Richard-Willke/Upper-Body_Exoskeleton/README.md

# Exoskeleton Project 

NOTE: A video of the project in action can be found [here](https://youtu.be/HH42bnDa1DE).

Goal of this project is the design of a rigid exoskeleton aimed to support elbow flexion-extension and wrist pronation-supination movements. 
The CAD model is shown below and can be found [here](https://github.com/Richard-Willke/Upper-Body_Exoskeleton/tree/main/Exoskeleton_Project_workspace/cad): 

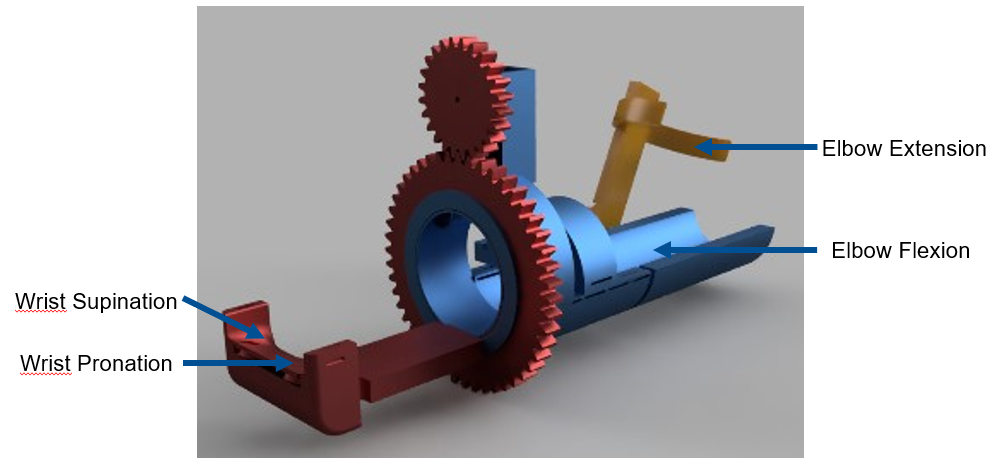
[picture p1: media/Screenshot_348.png]


## Program Architecture

The programme is split on two systems. An ESP32 microcontroller is used for low-level, real-time sensitive controls, while the high level commands and system kinematics & dynamics are being handled on a more powerful PC. The PC and microcontroller communicate with one another via a USB connection. 

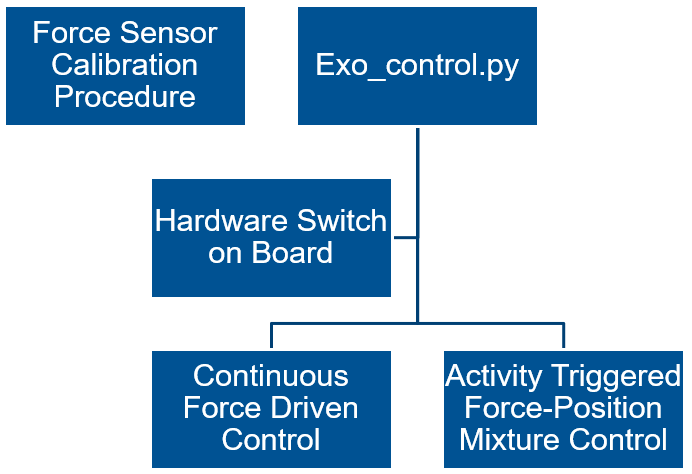
[picture p2: media/Screenshot_349.png]


## System Hardware

The system uses a force controlelr for action commands. Actuation is done using servo-motors and gear transmissions.  

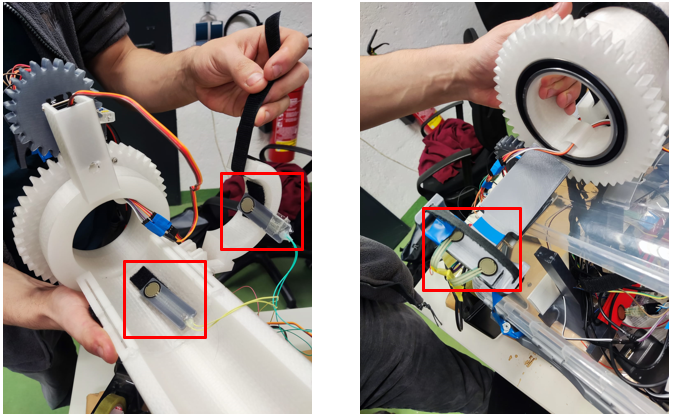
[picture p3: media/Screenshot_350.png]


## System Results 

pn

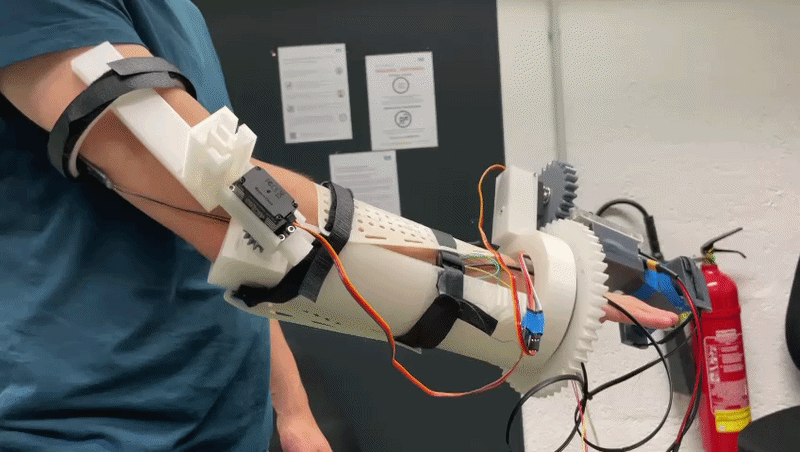
[picture p4: media/flex_extend.gif]
fe
