Richard-Willke/Upper-Body_Exoskeleton/Documentation/Closing_Presentation.pptx

## Practical Course Wearable Robotics Group 2: Wrist Pronation / Supination

- Lingfeng Gu, Richard Willke Nikolas Kaarsberg
- Technische Universität München
- TUM School of Computation, Information and Technology
- Institute for Congitive Systems
- Munich, 9. January 2024

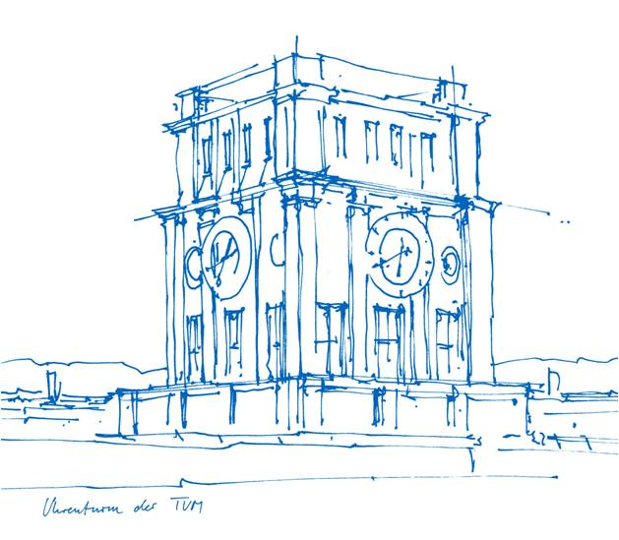
[picture p5: figure]

## Use Case

- Scenarios:
  - Picking up Cup for people with fast muscular fatigue
  - Learning of picking up motion for people with impaired RoM

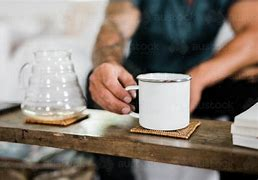
[picture p6: figure]
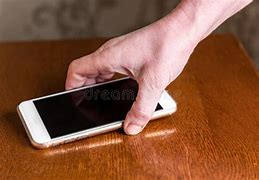
[picture p7: figure]
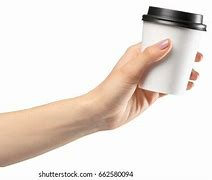
[picture p8: figure]

Lingfeng Gu, Richard Willke, Nikolas Kaarsberg | Wearable Robotics | Wrist Pronation & Supination

Notes: Picking up tasks / Grasping action
Goal: Helping People with muscular distrophy

## Approach

- Main Motion Contributers:
  - Elbow Flexion / Extension
  - Wrist Pronation / Supination
Assistive Modes:
    - Continuous Assistance
    - Activity Triggered
Requirements:
    - Ease of use
    - Reliability
    - Comfort
    - Realtime Capable

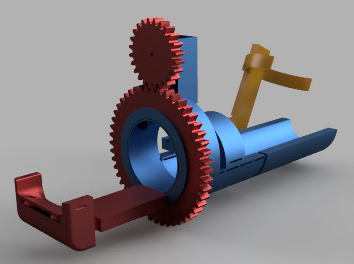
[picture p9: figure]

Notes: 2 DoF exoskeleton for muscular support
Elbow Flexion and Extension & Wrist Pronation / Supination as most important contributers for this task
Continuos assistance for first scenario
Activity triggered assistance for second scenario
Requirements:
Ease of use
Reliability
Comfort
Realtime capable

## Mechanical Design

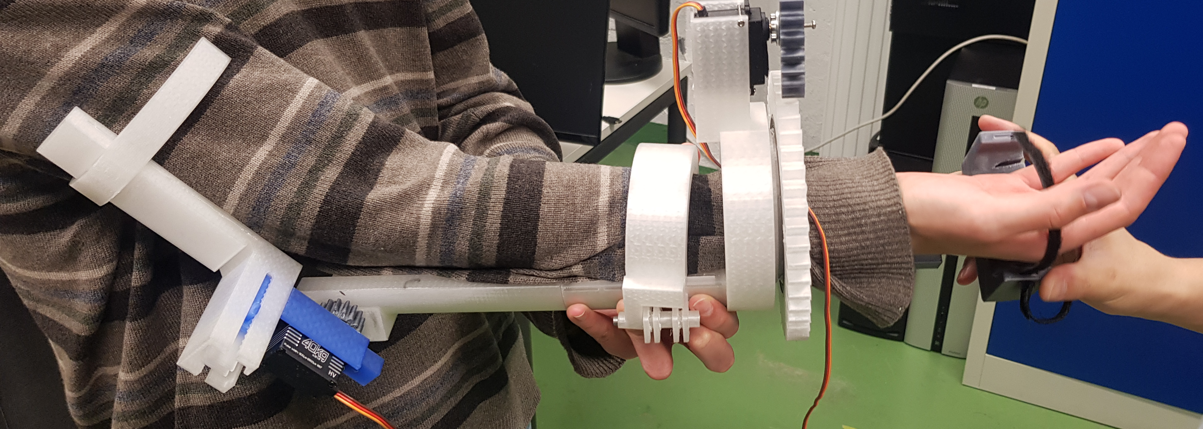
[picture p10: figure]
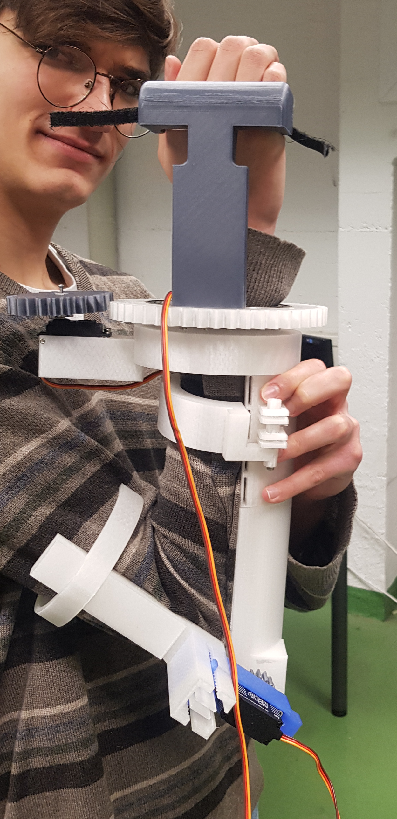
[picture p11: figure]
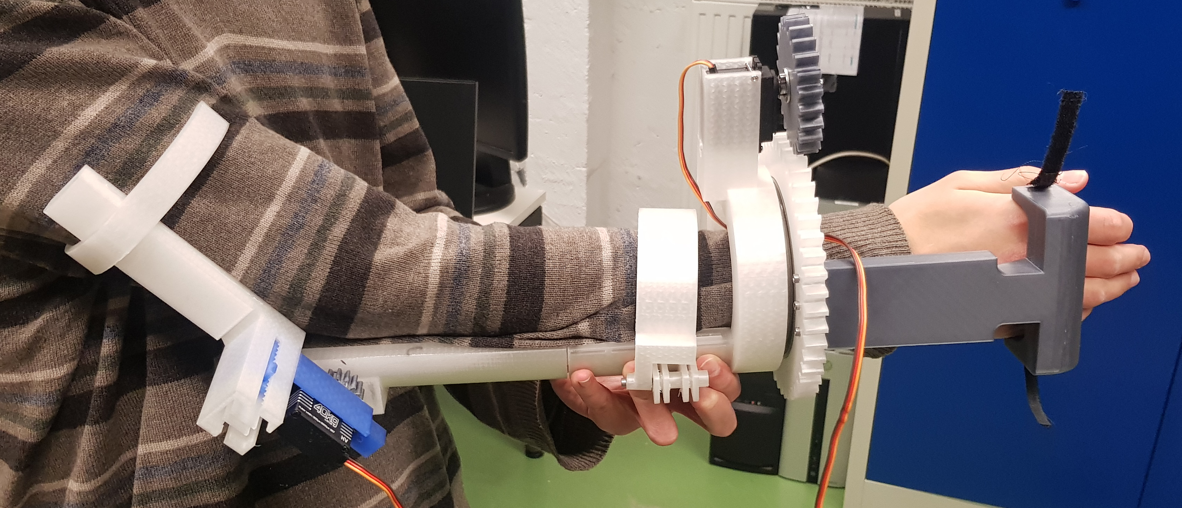
[picture p12: figure]

## Controls and Sensing

ESP32exo.ino

triggeredControl

- __init__
- deg2rad
- assist_loop2

open_serial_port.py

exoControl

- __init__
- deg2rad
- rad2deg
- checkRange
- control_loop

exo_control.py

## Controls and Sensing

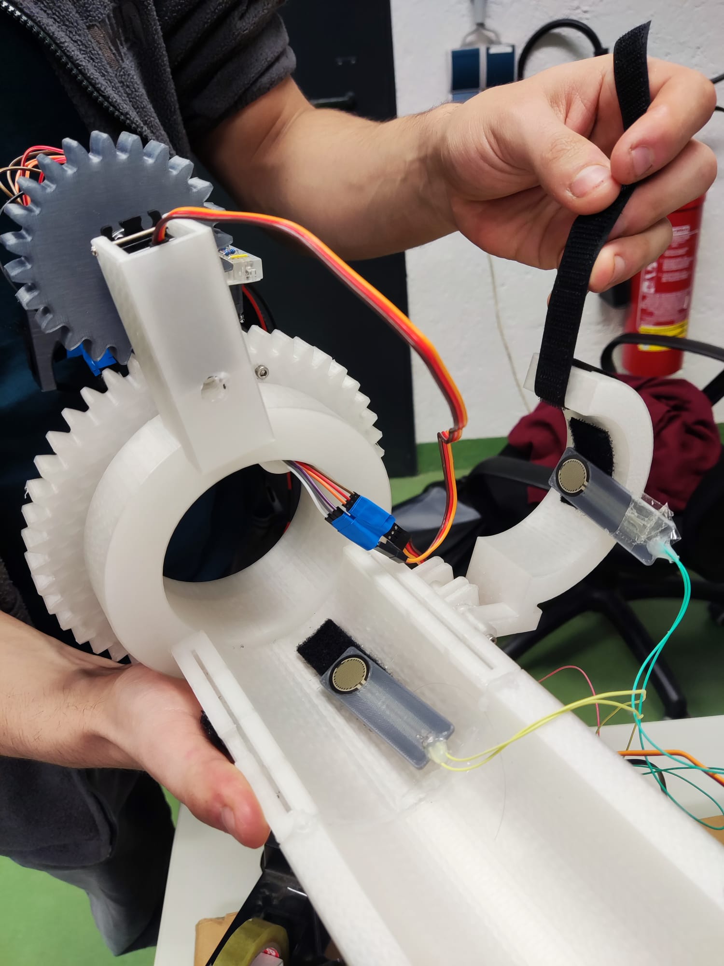
[picture p13: figure]
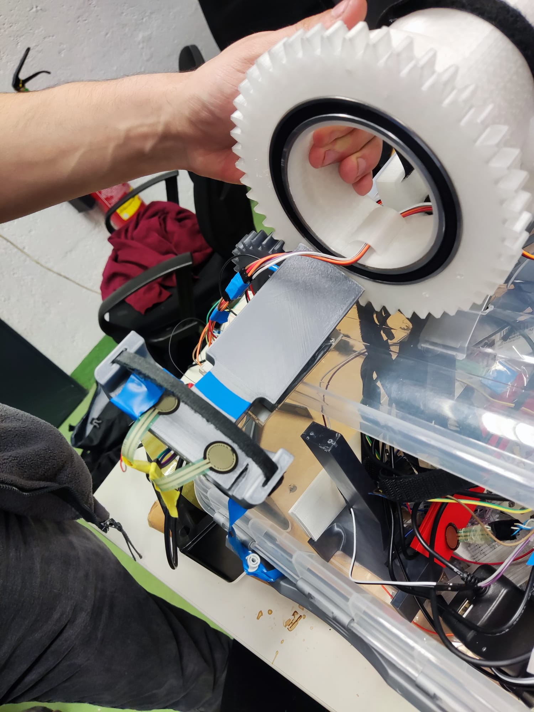
[picture p14: figure]

Notes: Using Force Sensors for both Control Modes
Sensors located along the outer knuckles of the hand and inner / outer side of lower arm
Used to calculate the wrench for both motions

## Results and Future Work

## Thank you for your attention!

Lingfeng Gu, Richard Willke, Nikolas Kaarsberg | Wearable Robotics | Wrist Pronation & Supination
