Richard-Willke/Upper-Body_Exoskeleton/Exoskeleton_Project_workspace/simulation/MATLAB Simulation/README.rtf

This matlab file shows the continuous control of a 2DOF model of exoskeleton with wrist pronation/suponation as well as elbow flexion/extension. This file structure is adapted and based on course of MSBRDM.
To see the simulation result, you can open the DSimulator_R2023a.mdl.
- modify the parameters at blocks q1d and q2d to see the result of trajectory following.

To use different control modes, go to the Tau.m file:
- uncomment the line 69. to enable the force control modes, then you can modify the parameter blocks tau1 & tau2 in Simulink to simulate the forces applied on both torques.
