Richard-Willke/Upper-Body_Exoskeleton/Exoskeleton_Project_workspace/cad/Exoskeleton_model.stl

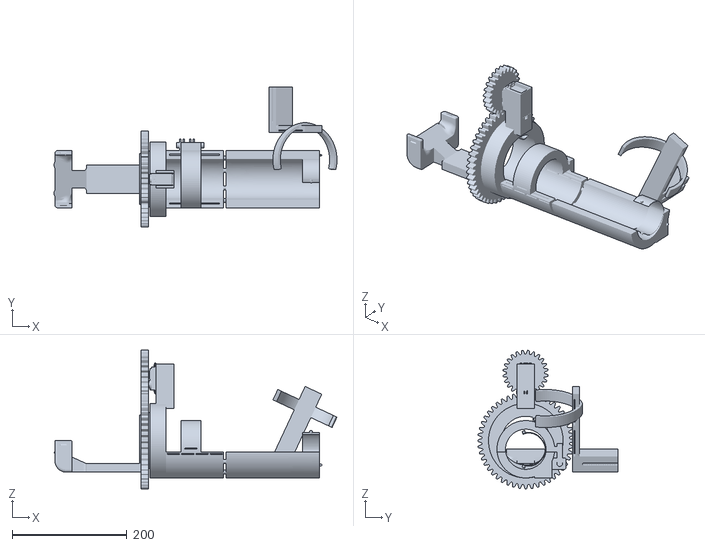
[picture p24: CAD file, 2026-10-08]
Exoskeleton_Project_workspace/cad/Exoskeleton_model.stl
493.4 x 244.8 x 241.5
