Richard-Willke/Upper-Body_Exoskeleton/Exoskeleton_Project_workspace/control/test.pdf

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

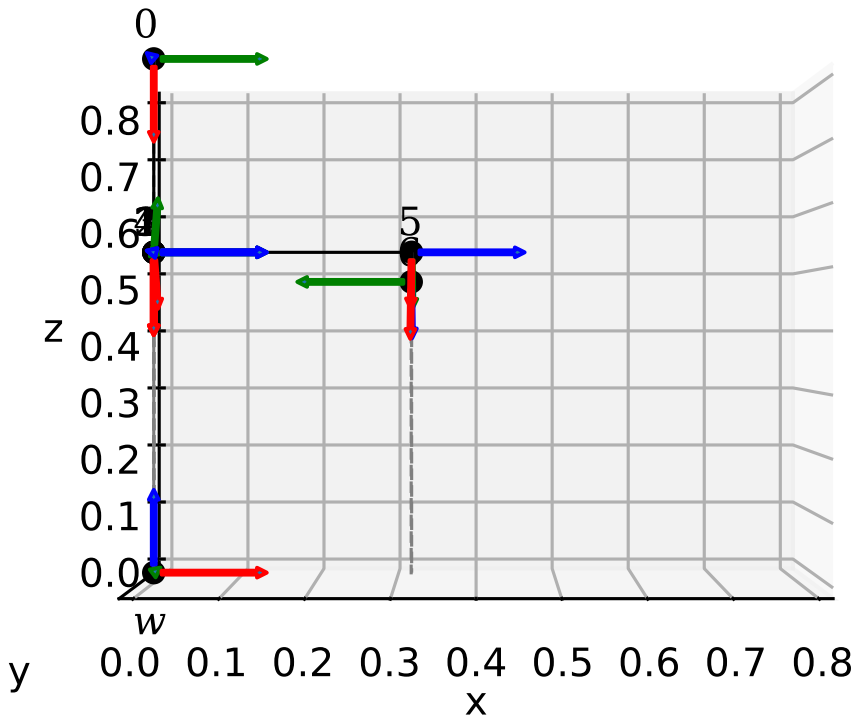
[picture p25: page 1]
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
