Richard-Willke/Upper-Body_Exoskeleton/(commit log)

2026-10-08 final code upload
    [Assembly of gear based exo v24.stl]
2026-10-08 added documentation
    [Exoskeleton_model.stl]
2026-10-08 updated folder nomenclature
    [Exoskeleton_model.stl]
